FelixChan9527/Shooting_robot/README.md

# Shooting_robot
2019广东省工科大学生实验综合竞赛一等奖寻龙队源码以及电路附带论文

* 源码需要用Keil5软件进行打开，否则注释会出现乱码现象。
* 电路文件需要用Altium Designer软件进行打开。
* 关于机器人的设计思路，在论文中详细说明，欢迎引用。
