FelixChan9527/Shooting_robot/电路设计/投篮机器人电机驱动部分/dirver2.pdf

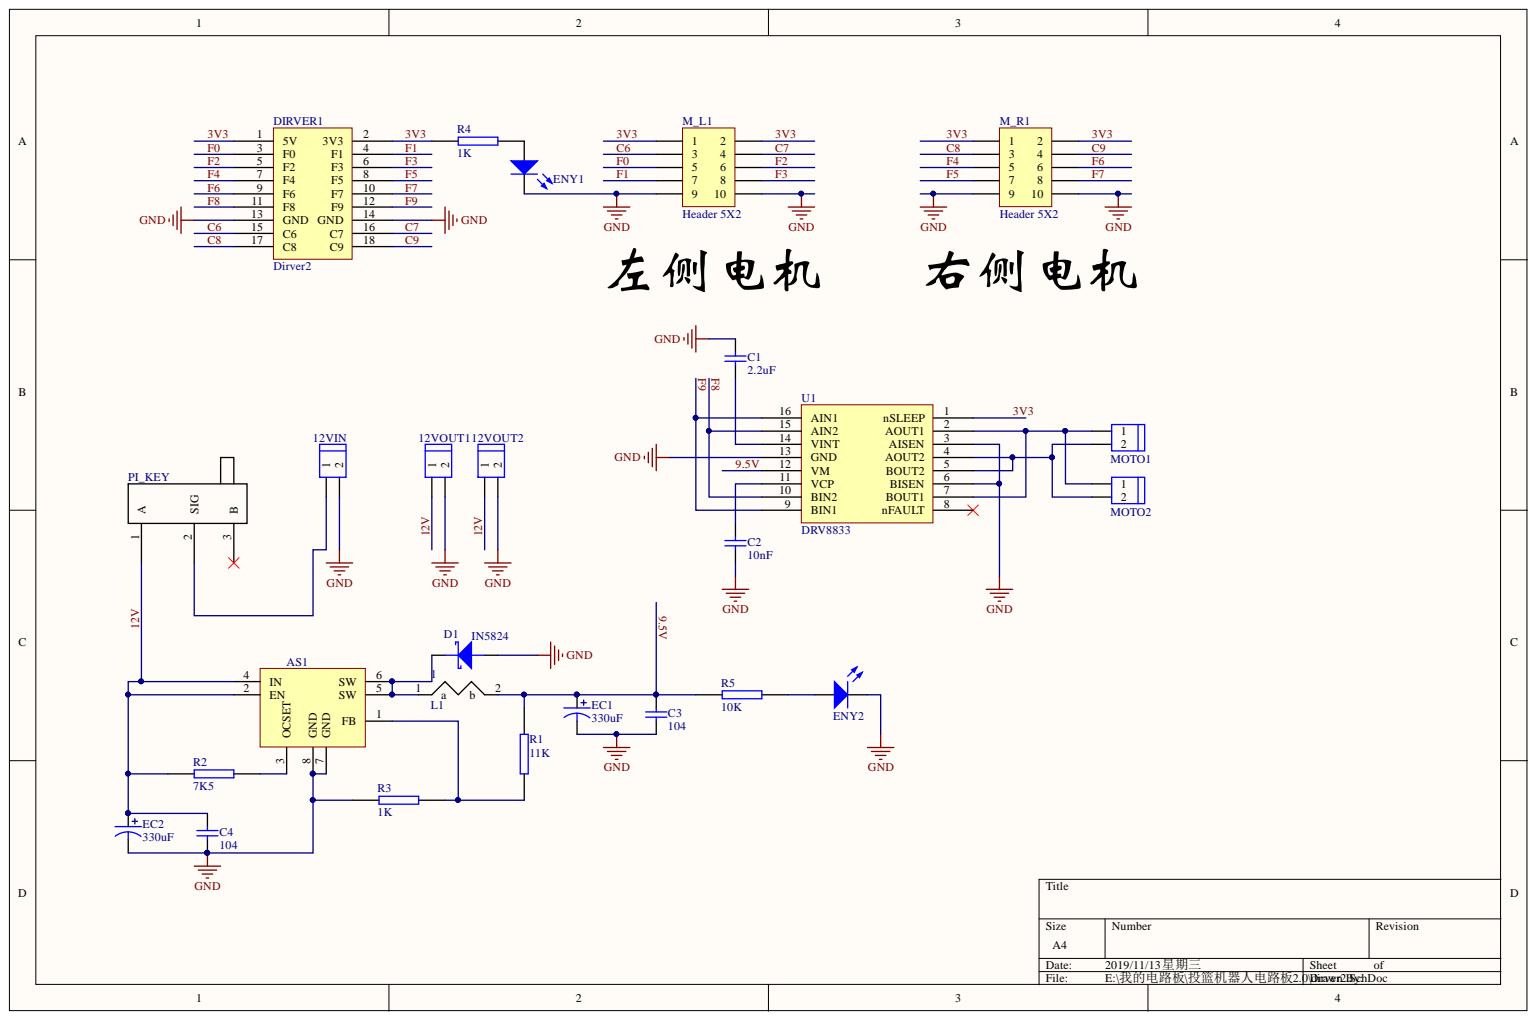
[picture p1: page 1]

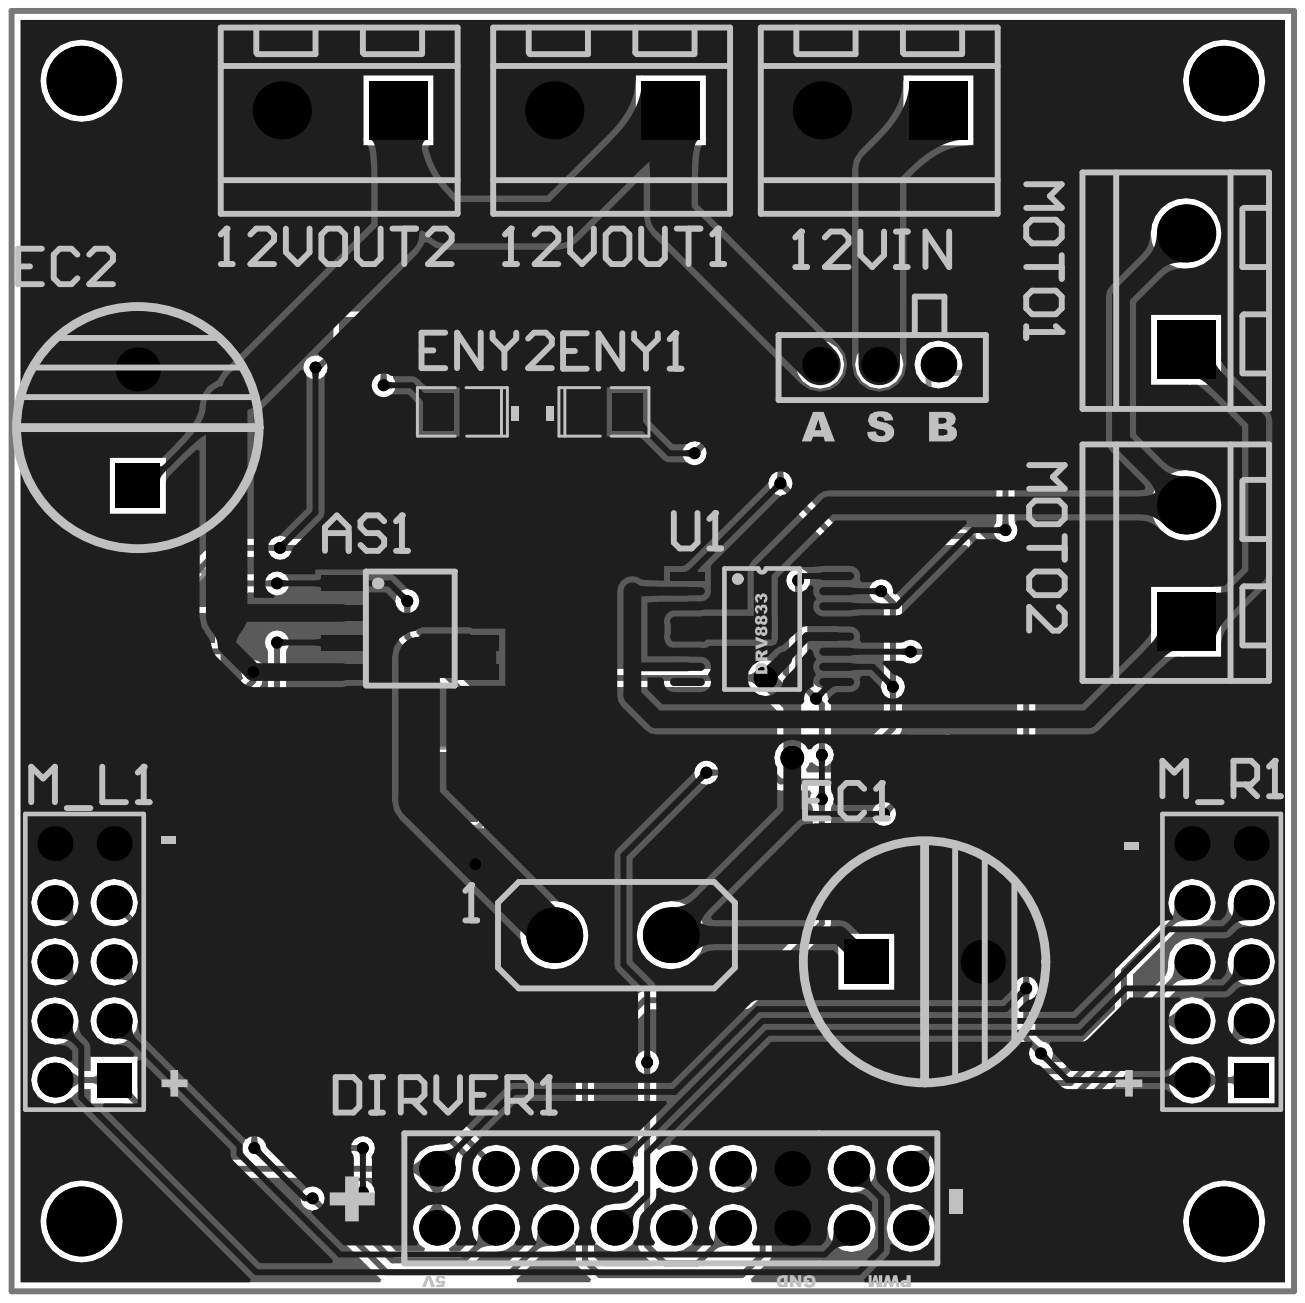
[picture p2: page 2]

Comment | Description | Designator | Footprint | LibRef | Quantity
L1 | | 1 | INDUCTOR | INDUCTOR | 1
HEAD2 | | 12VIN, 12VOUT1, 12VOUT2, MOTO1, MOTO2 | HEAD2L-0.8 | HEAD2 | 5
U1 | | AS1 | AS1015 | LED2 | 1
Cap | Cap | C1, C2, C3, C4 | CAP[0805] | Cap | 4
IN5824 | 肖特基二极管 | D1 | SMA/DO-214AC | DIODE SCHOTTKY | 1
Dirver2 | | DIRVER1 | DIRVER2 | Dirver2 | 1
330uF | 直插电解电容 | EC1, EC2 | DIP-EC5.0X10X12.5 | DIP_ECAP | 2
LED0 | LED0 | ENY1, ENY2 | LED[0805] | LED0 | 2
Header 5X2 | Header, 5-Pin, Dual row | M_L1, M_R1 | HDR2X5 | Header 5X2 | 2
PI_KEY | | PI_KEY1 | KEY | key | 1
11K | | R1 | R0805 | RES | 1
7K5 | | R2 | R0805 | RES | 1
1K | | R3, R4 | R0805 | RES | 2
10K | | R5 | R0805 | RES | 1
DRV8833 | | U1 | DRV8833 | DRV8833 | 1
