FelixChan9527/Shooting_robot/(list of files, drawings)

Other design files:
电路设计/投篮机器人电机驱动部分/dirver2.PrjPCB
电路设计/投篮机器人电机驱动部分/dirver2.SchDoc
电路设计/投篮机器人电机驱动部分/dirver3.PcbDoc
电路设计/投篮机器人电路主控制与电源系统设计/Device.SchDoc
电路设计/投篮机器人电路主控制与电源系统设计/Energy.SchDoc
电路设计/投篮机器人电路主控制与电源系统设计/robot2.PcbLib
电路设计/投篮机器人电路主控制与电源系统设计/robot2.PrjPCB
电路设计/投篮机器人电路主控制与电源系统设计/robot2.SchLib
电路设计/投篮机器人电路主控制与电源系统设计/SYSTEM.SchDoc
