FelixChan9527/Shooting_robot/投篮机器人源码/HEARDWARE/Exti/exti.c

#include "exti.h"
#include "delay.h" 

void EXTIX_Init(void)
{
	NVIC_InitTypeDef   NVIC_InitStructure;
	EXTI_InitTypeDef   EXTI_InitStructure;
	
	KEY_Init(); //按键对应的IO口初始化
 
	RCC_APB2PeriphClockCmd(RCC_APB2Periph_SYSCFG, ENABLE);//使能SYSCFG时钟
	
 
	SYSCFG_EXTILineConfig(EXTI_PortSourceGPIOE, EXTI_PinSource2);//PE2 连接到中断线2
	SYSCFG_EXTILineConfig(EXTI_PortSourceGPIOE, EXTI_PinSource3);//PE3 连接到中断线3
	SYSCFG_EXTILineConfig(EXTI_PortSourceGPIOE, EXTI_PinSource4);//PE4 连接到中断线4
	SYSCFG_EXTILineConfig(EXTI_PortSourceGPIOA, EXTI_PinSource0);//PA0 连接到中断线0
	
  /* 配置EXTI_Line0 */
  EXTI_InitStructure.EXTI_Line = EXTI_Line0;//LINE0
  EXTI_InitStructure.EXTI_Mode = EXTI_Mode_Interrupt;//中断事件
  EXTI_InitStructure.EXTI_Trigger = EXTI_Trigger_Rising; //上升沿触发 
  EXTI_InitStructure.EXTI_LineCmd = ENABLE;//使能LINE0
  EXTI_Init(&EXTI_InitStructure);//配置
	
	/* 配置EXTI_Line2,3,4 */
	EXTI_InitStructure.EXTI_Line = EXTI_Line2 | EXTI_Line3 | EXTI_Line4;
  EXTI_InitStructure.EXTI_Mode = EXTI_Mode_Interrupt;//中断事件
  EXTI_InitStructure.EXTI_Trigger = EXTI_Trigger_Falling; //下降沿触发
  EXTI_InitStructure.EXTI_LineCmd = ENABLE;//中断线使能
  EXTI_Init(&EXTI_InitStructure);//配置
 
	NVIC_InitStructure.NVIC_IRQChannel = EXTI0_IRQn;//外部中断0
  NVIC_InitStructure.NVIC_IRQChannelPreemptionPriority = 0x00;//抢占优先级0
  NVIC_InitStructure.NVIC_IRQChannelSubPriority = 0x02;//子优先级2
  NVIC_InitStructure.NVIC_IRQChannelCmd = ENABLE;//使能外部中断通道
  NVIC_Init(&NVIC_InitStructure);//配置
	
	NVIC_InitStructure.NVIC_IRQChannel = EXTI2_IRQn;//外部中断2
  NVIC_InitStructure.NVIC_IRQChannelPreemptionPriority = 0x03;//抢占优先级3
  NVIC_InitStructure.NVIC_IRQChannelSubPriority = 0x02;//子优先级2
  NVIC_InitStructure.NVIC_IRQChannelCmd = ENABLE;//使能外部中断通道
  NVIC_Init(&NVIC_InitStructure);//配置
	
	
	NVIC_InitStructure.NVIC_IRQChannel = EXTI3_IRQn;//外部中断3
  NVIC_InitStructure.NVIC_IRQChannelPreemptionPriority = 0x02;//抢占优先级2
  NVIC_InitStructure.NVIC_IRQChannelSubPriority = 0x02;//子优先级2
  NVIC_InitStructure.NVIC_IRQChannelCmd = ENABLE;//使能外部中断通道
  NVIC_Init(&NVIC_InitStructure);//配置
	
	
	NVIC_InitStructure.NVIC_IRQChannel = EXTI4_IRQn;//外部中断4
  NVIC_InitStructure.NVIC_IRQChannelPreemptionPriority = 0x01;//抢占优先级1
  NVIC_InitStructure.NVIC_IRQChannelSubPriority = 0x02;//子优先级2
  NVIC_InitStructure.NVIC_IRQChannelCmd = ENABLE;//使能外部中断通道
  NVIC_Init(&NVIC_InitStructure);//配置
	   
}
