FelixChan9527/Shooting_robot/(notices)

Notices in the files:
投篮机器人源码/SYSTEM/usart/usart.c:
Copyright(C) ¹ãÖÝÊÐÐÇÒíµç×Ó¿Æ¼¼ÓÐÏÞ¹«Ë¾ 2009-2019
All rights reserved
